shuiqiling/-stm32f103C8T6-PCB-/THIRD_PARTY.md

# 第三方代码与说明

| 路径 | 来源 |
| --- | --- |
| `firmware/Libraries/CMSIS/` | ARM CMSIS Cortex-M3 与 ST STM32F10x 器件支持；保留文件原始版权和使用说明 |
| `firmware/Libraries/STM32F10x_StdPeriph_Driver/` | STMicroelectronics 标准外设库 V3.5.0；保留原始版权和使用说明 |
| `firmware/User/stm32f10x_conf.h`、`stm32f10x_it.c`、`stm32f10x_it.h` | 原工程的 ST 配置/中断模板及其修改，以文件头为准 |

硬件设计参考公开教程完成。未为第三方文件重新指定许可证，也未为作者代码新增统一 MIT 等许可。复用前请查看对应文件原始说明；作者代码的统一许可可由作者后续明确。
