shuiqiling/-stm32f103C8T6-PCB-/hardware/pcb/pcb-layout.pdf

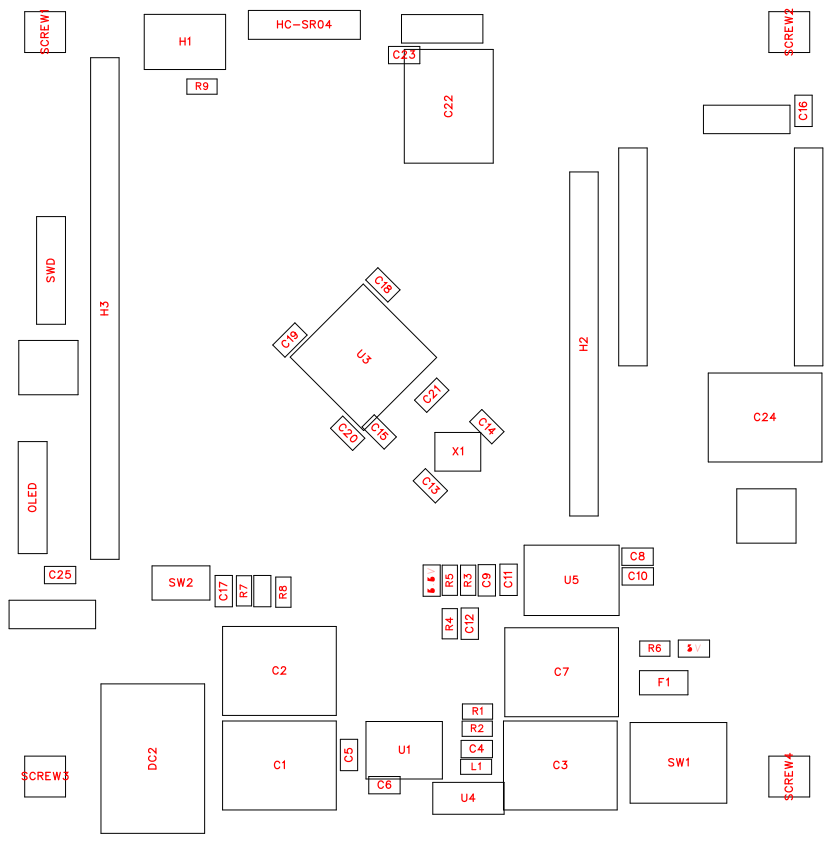
[picture p3: page 1]

No. | Quantity | Comment | Designator | Footprint | Value | Manufacturer Part | Manufacturer | Supplier Part | Supplier | Device | Name
1 | 3 | LED_0603-G | 3.3V指示灯,5V指示灯,复位 指示灯 | LED_0603 | | | | | | LED_0603-G
2 | 3 | 470UF | C1,C22,C24 | CAP-SMD_B D8.0-L8.3-W 8.3-LS9.3-FD -2 | | 470UF | | C990002296 7 | LCSC | 铝电解电容 | 470UF
3 | 1 | 10UF | C2 | CAP-SMD_B D8.0-L8.3-W 8.3-LS9.3-FD -2 | | 10UF | | C990002296 7 | LCSC | 铝电解电容 | 10UF
4 | 1 | 22UF | C3 | CAP-SMD_B D8.0-L8.3-W 8.3-LS9.3-FD -2 | | 22UF | | C990002296 7 | LCSC | 铝电解电容 | 22UF
5 | 13 | 100nF | C4,C5,C6,C8,C11,C12,C15, C17,C18,C19,C20,C21,C23 | C0603 | 100nF | | | | | CAP_0603 | 100nF
6 | 1 | 100UF | C7 | CAP-SMD_B D8.0-L8.3-W 8.3-LS9.3-FD -2 | | 100UF | | C990002296 7 | LCSC | 铝电解电容 | 100UF
7 | 2 | 10UF | C9,C10 | C0603 | 10UF | | | | | CAP_0603 | 10UF
8 | 2 | 20pF | C13,C14 | C0603 | 20pF | | | | | CAP_0603 | 20pF
9 | 2 | 1nF | C16,C25 | C0603 | 1nF | | | | | CAP_0603 | 1nF
10 | 1 | DC-005_2.0 | DC2 | DC-2.0 | | | | | | DC-005_2.0
11 | 1 | JK-nSMD005 | F1 | F1206 | | JK-nSMD005 | JK(金科) | C369153 | LCSC | JK-nSMD005 | JK-nSMD005
12 | 1 | HDR-M_2.54 _2x3 | H1 | HDR-TH_6P-P2.54-V-R2-C3-S2.54_A2 541WV-2X3P | | | | C402781 | | HDR-M_2.54 _2x3
13 | 1 | HDR-M_2.54 _1x13P | H2 | HDR-TH_13 P-P2.54-V-M | | | | C2894936 | | HDR-M_2.54 _1x13P
14 | 1 | HDR-M_2.54 _1x19P | H3 | HDR-TH_19 P-P2.54-V-M | | | | C725951 | | HDR-M_2.54 _1x19P
15 | 2 | HDR-F_2.54 _1x4P | HC-SR04,OLED | HDR-TH_4P-P2.54-V-F | | | | C2718488 | | HDR-F_2.54 _1x4P
16 | 1 | 15uH | L1 | L0603 | 15uH | | | | | L_0603 | 15uH
17 | 4 | 10K | R1,R6,R7,R9 | R0603 | 10K | | | | | Res_0603 | 10K
18 | 1 | 3.16K | R2 | R0603 | 3.16K | | | | | Res_0603 | 3.16K
19 | 2 | 0 | R3,R4 | R0603 | 0 | | | | | Res_0603 | 0
20 | 2 | 4.7K | R5,R8 | R0603 | 4.7K | | | | | Res_0603 | 4.7K
21 | 4 | M2螺丝 | SCREW1,SCREW2,SCRE W3,SCREW4 | M2螺丝 | | | | | | M2螺丝
22 | 1 | 滑动开关6P 贴片,两档 | SW1 | SW-SMD_6P -L9.0-W3.5-P 2.50-LS6.8 | | 滑动开关6P 贴片,两档 | | C990002102 5 | LCSC | 滑动开关6P 贴片,两档 | 滑动开关6P 贴片,两档
23 | 1 | Key_SMD_3 x4x2 | SW2 | Key_SMD_3 x4x2 | | | | | | Key_SMD_3 x4x2

24 | 1 | HDR-M_2.54 _1x4P | SWD | HDR-TH_4P-P2.54-V-M | | | | C492403 | | HDR-M_2.54 _1x4P
25 | 1 | TPS5450QD DARQ1 | U1 | SOIC-8_L4.9 -W3.9-P1.27-LS6.0-BL-EP | | TPS5450QD DARQ1 | TI(德州仪器 ) | C181270 | LCSC | TPS5450QD DARQ1 | TPS5450QD DARQ1
26 | 1 | STM32F103 C8T6 | U3 | LQFP-48_L7. 0-W7.0-P0.5 0-LS9.0-BL | | STM32F103 C8T6 | ST(意法半导 体) | C8734 | LCSC | STM32F103 C8T6 | STM32F103 C8T6
27 | 1 | SS54 | U4 | SMA_L4.2-W 2.6-LS5.1-R D | | SS54 | | C990002321 9 | LCSC | SS54 | SS54
28 | 1 | AMS1117-3. 3 | U5 | SOT-223-3_L 6.5-W3.4-P2. 30-LS7.0-BR | | AMS1117-3. 3 | AMS | C6186 | LCSC | AMS1117-3. 3_C6186 | AMS1117-3. 3
29 | 1 | 8MHz | X1 | CRYSTAL-S MD_4P-L3.2-W2.5-BL | 8MHz | X32258MOB 4SI | YXC(扬兴晶 振) | C2682775 | LCSC | X32258MOB 4SI | 8MHz
30 | 2 | HDR-F_2.54 _1x8P | 右排针 ,左排针 | HDR-TH_8P-P2.54-V-F-1 | | | | C27438 | | HDR-F_2.54 _1x8P
31 | 2 | HDR-F_2.54 _1x3P | 右测速 ,左测速 | HDR-TH_3P-P2.54-V-F | | | | C541850 | | HDR-F_2.54 _1x3P
32 | 2 | HDR-F_2.54 _2x2 | 右电机 ,左电机 | HDR-TH_4P-P2.54-V-F-R 2-C2-S2.54 | | | | C92273 | | HDR-F_2.54 _2x2
33 | 1 | HDR-M_2.54 _1x3P | 舵机 | HDR-TH_3P-P2.54-V-M | | | | C2937625 | | HDR-M_2.54 _1x3P

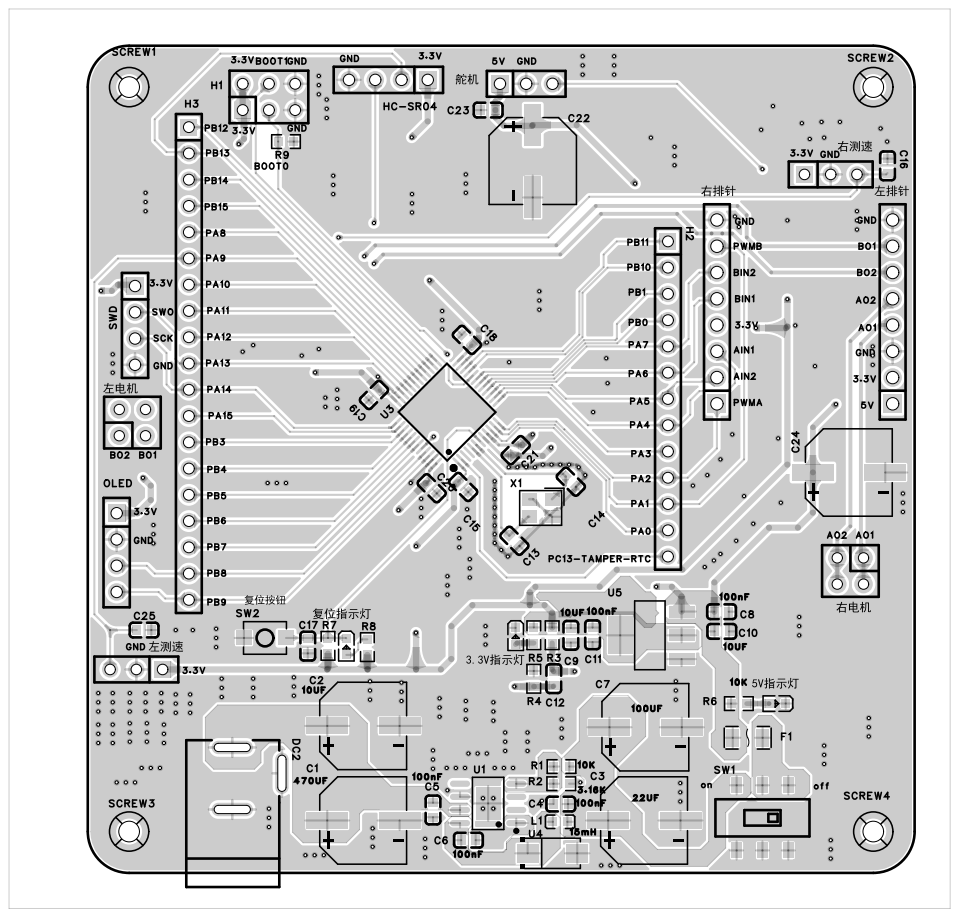
[picture p4: page 5]

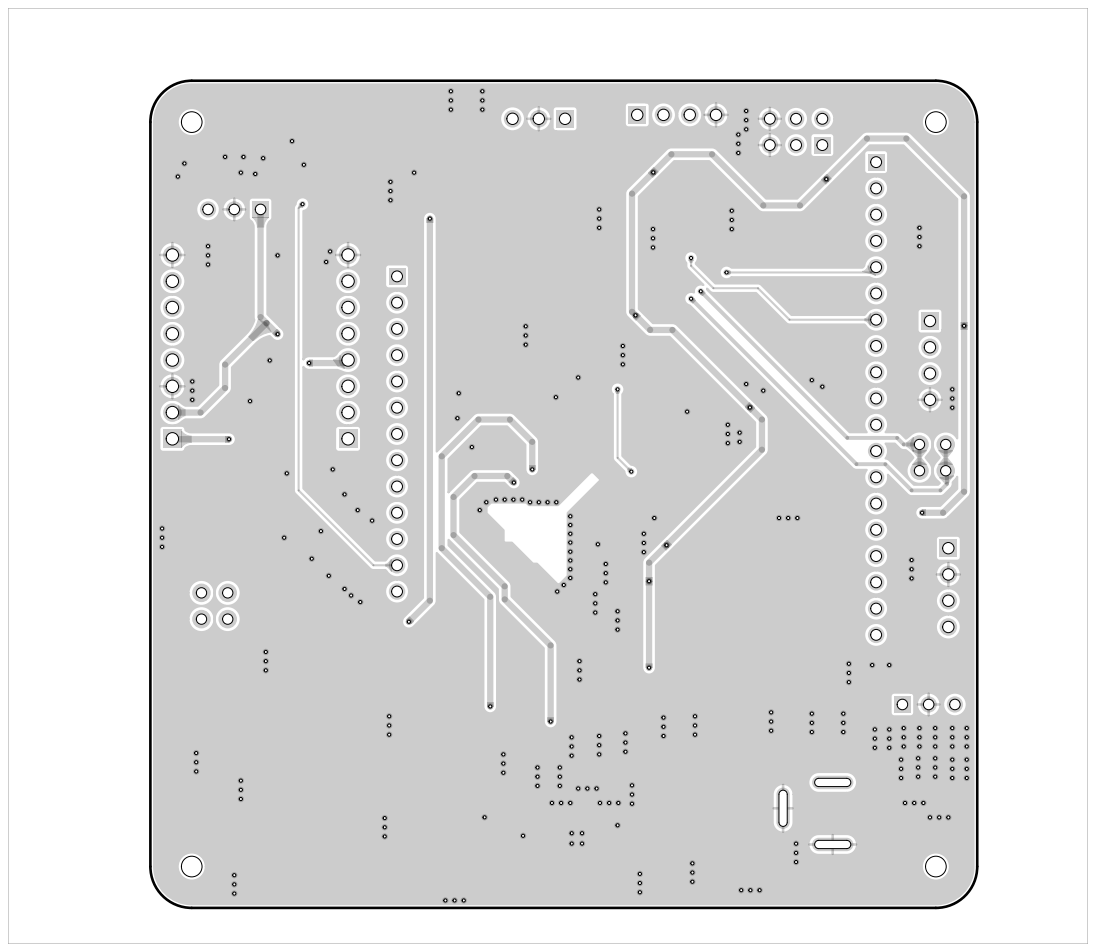
[picture p5: page 6]

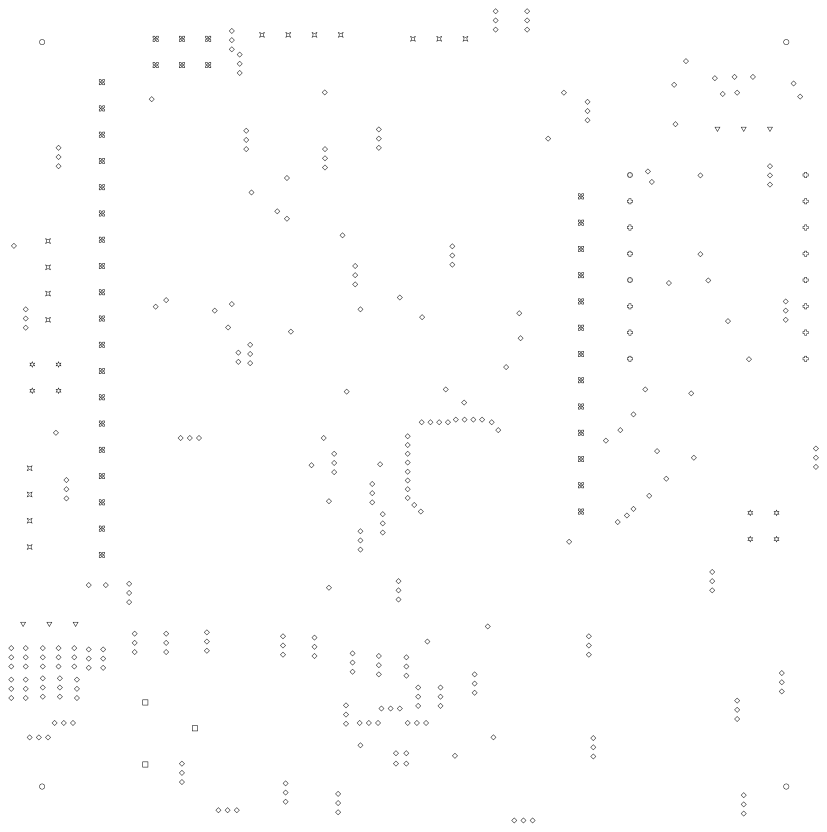
[picture p6: page 7]
