shuiqiling/-stm32f103C8T6-PCB-/hardware/schematic/schematic.pdf

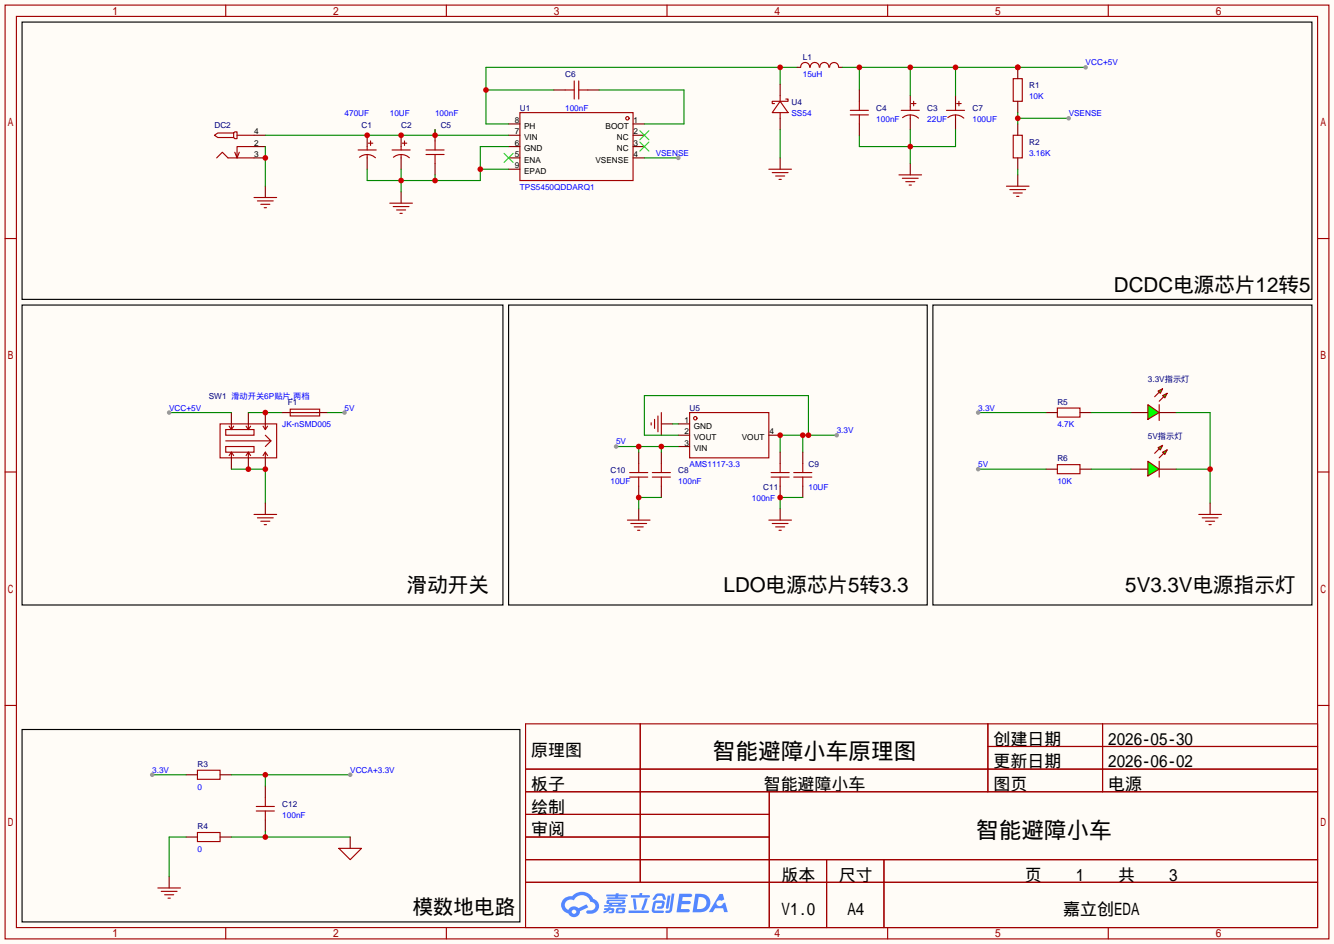
[picture p7: page 1]

原理图 | 智能避障小车原理图 | 创建日期 | 2026-05-30

更新日期 | 2026-06-02

板子 | 智能避障小车 | 图页 | 电源
绘制 | | 智能避障小车
审阅

V1.0 | A4 | 嘉立创EDA

晶振电路 | BOOT配置

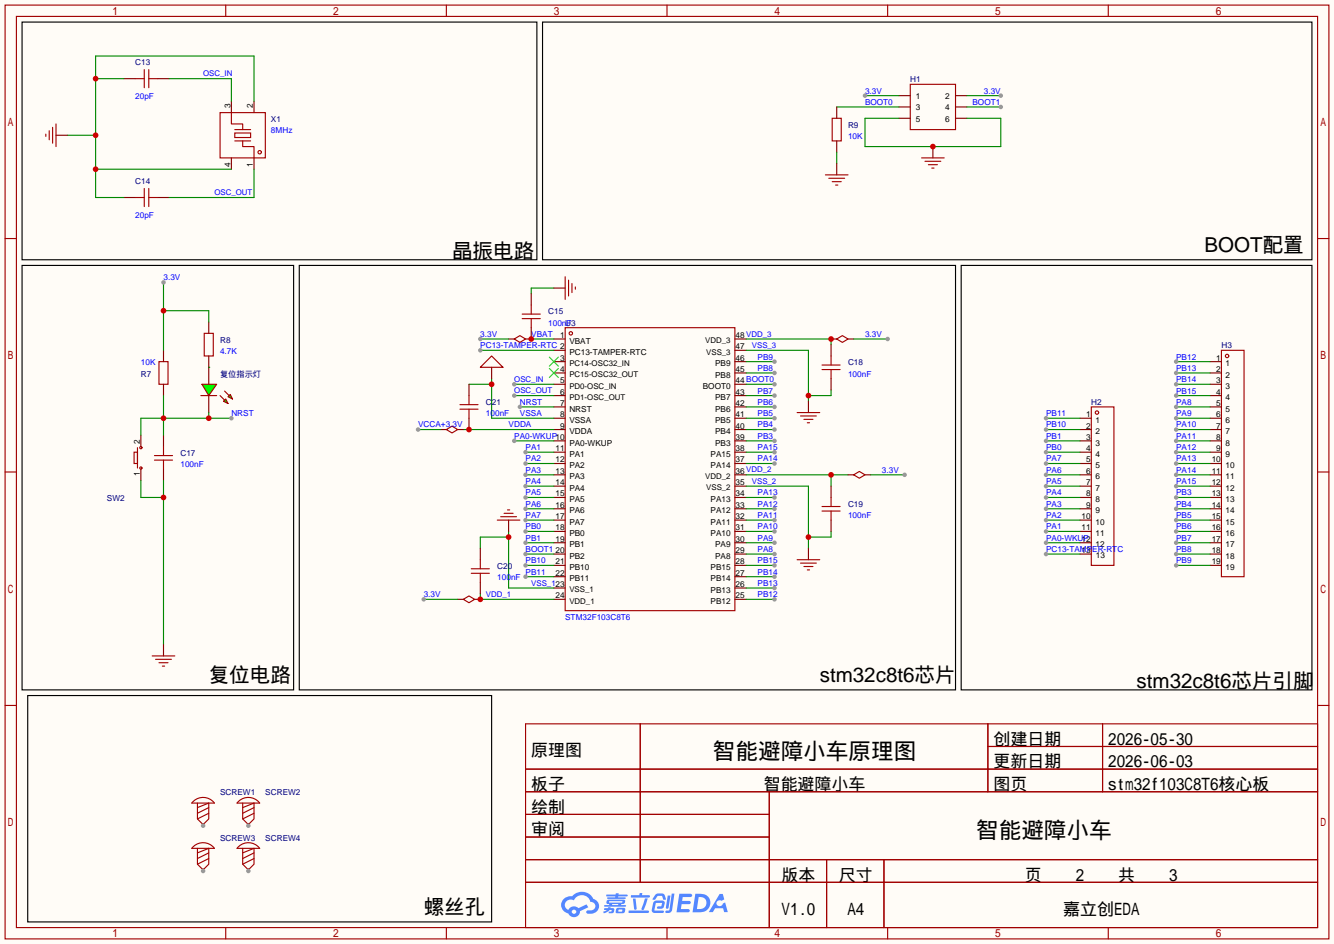
[picture p8: page 2]

原理图 | 智能避障小车原理图 | 创建日期 | 2026-05-30

更新日期 | 2026-06-03

板子 | 智能避障小车 | 图页 | stm32f103C8T6核心板
绘制 | | 智能避障小车
审阅

# Motor： in1：A4(A),A6(B)；

in2：A5(A),A7(B);

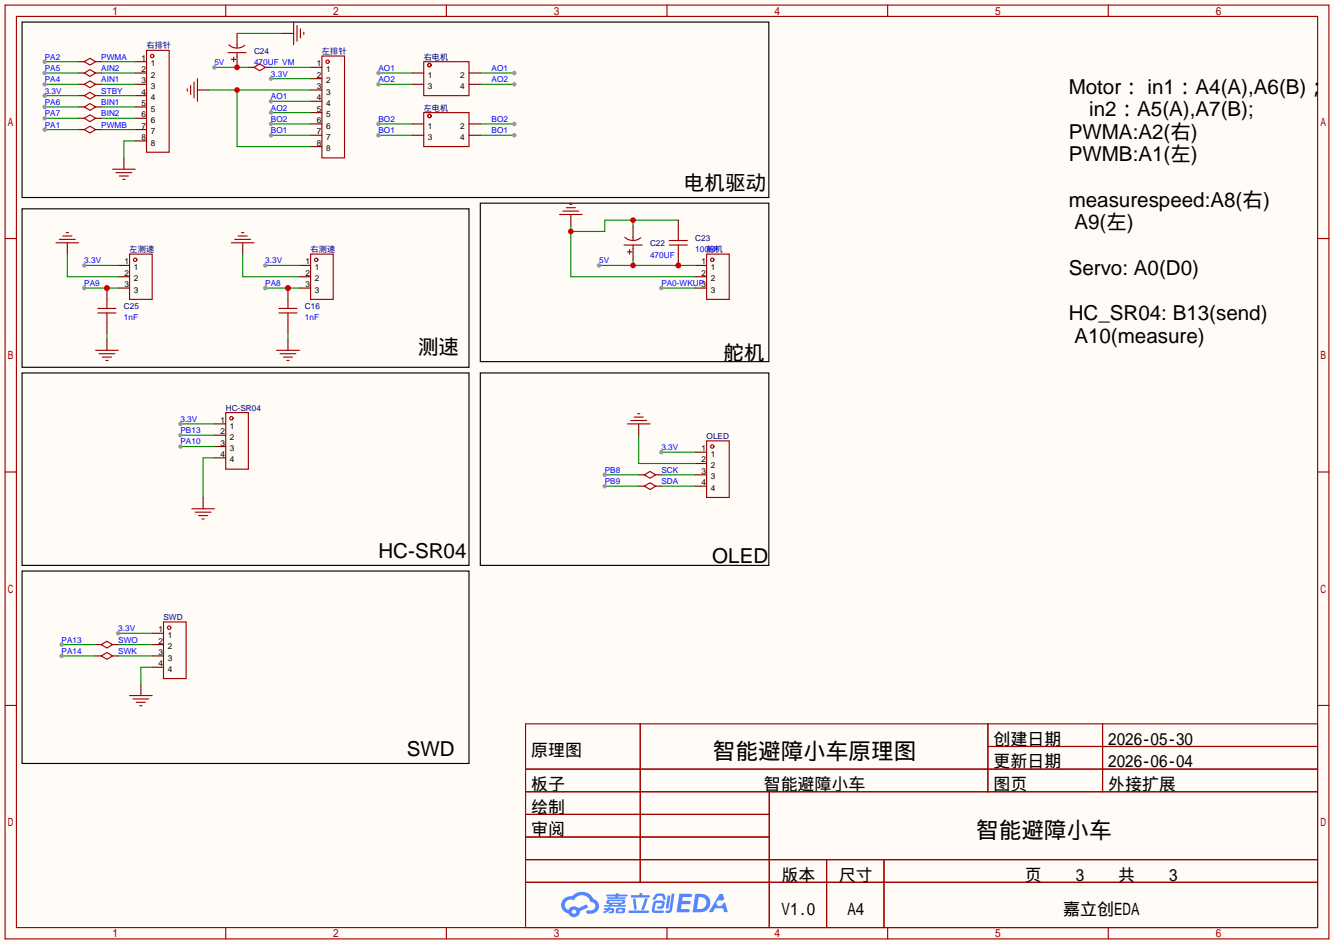
[picture p9: page 3]

原理图 | 智能避障小车原理图 | 创建日期 | 2026-05-30

更新日期 | 2026-06-04

板子 | 智能避障小车 | 图页 | 外接扩展
绘制 | | 智能避障小车
审阅
