shuiqiling/-stm32f103C8T6-PCB-/firmware/Hardware/Encoder.c

#include "stm32f10x.h"    // Device header
int16_t Temp;
int16_t Now;
void Encoder_Init(void)
{
	RCC_APB2PeriphClockCmd(RCC_APB2Periph_GPIOA,ENABLE);
	RCC_APB1PeriphClockCmd(RCC_APB1Periph_TIM3,ENABLE);

	GPIO_InitTypeDef GPIO_InitStruct;
	GPIO_InitStruct.GPIO_Mode=GPIO_Mode_IPU;
	GPIO_InitStruct.GPIO_Pin=GPIO_Pin_6|GPIO_Pin_7;
	GPIO_InitStruct.GPIO_Speed=GPIO_Speed_50MHz;
	GPIO_Init(GPIOA,&GPIO_InitStruct);


	TIM_TimeBaseInitTypeDef TIM_TimeBaseInitStruct;
	TIM_TimeBaseInitStruct.TIM_ClockDivision=TIM_CKD_DIV1;
	TIM_TimeBaseInitStruct.TIM_CounterMode=TIM_CounterMode_Up;
	TIM_TimeBaseInitStruct.TIM_Period=65536-1;
	TIM_TimeBaseInitStruct.TIM_Prescaler=1-1;
	TIM_TimeBaseInitStruct.TIM_RepetitionCounter=0x00;
	TIM_TimeBaseInit(TIM3,&TIM_TimeBaseInitStruct);

    TIM_ICInitTypeDef TIM_ICInitStruct;

	TIM_ICStructInit(&TIM_ICInitStruct);

	TIM_ICInitStruct.TIM_Channel=TIM_Channel_1;
	TIM_ICInitStruct.TIM_ICSelection=TIM_ICSelection_DirectTI;
	TIM_ICInitStruct.TIM_ICFilter=0xF;
	TIM_ICInit(TIM3,&TIM_ICInitStruct);

	TIM_ICStructInit(&TIM_ICInitStruct);
	TIM_ICInitStruct.TIM_Channel=TIM_Channel_2;
	TIM_ICInitStruct.TIM_ICSelection=TIM_ICSelection_DirectTI;
	TIM_ICInitStruct.TIM_ICFilter=0xF;
	TIM_ICInit(TIM3,&TIM_ICInitStruct);
	TIM_EncoderInterfaceConfig(TIM3,TIM_EncoderMode_TI12,TIM_ICPolarity_Rising,TIM_ICPolarity_Rising);

	TIM_SetCounter(TIM3,0);
	TIM_Cmd(TIM3,ENABLE);
}

int16_t Encoder_Getcount(void)
{
	return TIM_GetCounter(TIM3)+1;
}


int16_t Encoder_GetSpeed(void)
{
	Now=TIM_GetCounter(TIM3)-Temp;
    Temp=TIM_GetCounter(TIM3);
	return Now;


}
