shuiqiling/-stm32f103C8T6-PCB-/firmware/HAL/HAL.h

#ifndef __HAL_H
#define __HAL_H

#include <stdlib.h>

#include "Delay.h"                  // Device header
#include "OLED.h"
#include "Servo.h"
#include "TIM.h"
#include "PWM.h"
#include "Motor.h"
#include "MPU6050.h"
#include "MeasureSpeed.h"
#include "HC_SR04.h"



#include "HAL_MeasureSpeed.h"
#include "HAL_Servo.h"
#include "HAL_PWM.h"
#include "HAL_Motor.h"
#include "HAL_MPU6050.h"
#include "HAL_HC_SR04.h"

#include "MotorPID.h"
#include "Filtering.h"
#include "Sorting.h"



#include "APP_ActionControl.h"
#include "APP_Obstacle_Avoidance.h"



#endif
