shuiqiling/-stm32f103C8T6-PCB-/firmware/HAL/HAL_MPU6050.h

#ifndef __HAL_MPU6050_H
#define __HAL_MPU6050_H

void HAL_MPU6050_Init(void);

void HAL_MPU6050_SendByte(uint8_t MPU6050_Address,uint8_t SendByte);
uint8_t HAL_MPU6050_ReadByte(uint8_t MPU6050_Address);

void HAL_MPU6050_GetAGValue(int16_t *Ax,int16_t *Ay,int16_t *Az,int16_t *Gx,int16_t *Gy,int16_t *Gz);



#endif
