shuiqiling/-stm32f103C8T6-PCB-/firmware/Hardware/BUZ.c

#include "stm32f10x.h"                  // Device header


void BUZ_Init(void)
{
	RCC_APB2PeriphClockCmd(RCC_APB2Periph_GPIOB,ENABLE);
	GPIO_InitTypeDef GPIO_InitB;
	GPIO_InitB.GPIO_Mode=GPIO_Mode_Out_PP;
	GPIO_InitB.GPIO_Pin=GPIO_Pin_12;
	GPIO_InitB.GPIO_Speed=GPIO_Speed_50MHz;
	GPIO_Init(GPIOB,&GPIO_InitB);
}
