shuiqiling/-stm32f103C8T6-PCB-/firmware/Hardware/PWM.c

#include "stm32f10x.h"                  // Device header

void PWM_Init(void)
{
	RCC_APB1PeriphClockCmd(RCC_APB1Periph_TIM2,ENABLE);

	TIM_InternalClockConfig(TIM2);
	TIM_TimeBaseInitTypeDef TIM_TimeBaseInitStruct;
	TIM_TimeBaseInitStruct.TIM_ClockDivision=TIM_CKD_DIV1;
	TIM_TimeBaseInitStruct.TIM_CounterMode=TIM_CounterMode_Up;
	TIM_TimeBaseInitStruct.TIM_Period=20000-1;
	TIM_TimeBaseInitStruct.TIM_Prescaler=72-1;
	TIM_TimeBaseInitStruct.TIM_RepetitionCounter=0x00;
	TIM_TimeBaseInit(TIM2, &TIM_TimeBaseInitStruct);

	TIM_OCInitTypeDef TIM_OCInitStruct;
	TIM_OCStructInit(&TIM_OCInitStruct);

	TIM_OCInitStruct.TIM_OCMode=TIM_OCMode_PWM1;
	TIM_OCInitStruct.TIM_OCPolarity=TIM_OCPolarity_High;
	TIM_OCInitStruct.TIM_OutputState=TIM_OutputState_Enable;
	TIM_OCInitStruct.TIM_Pulse=0;
	TIM_OC1Init(TIM2,&TIM_OCInitStruct);

	TIM_OCInitStruct.TIM_OCMode=TIM_OCMode_PWM1;
	TIM_OCInitStruct.TIM_OCPolarity=TIM_OCPolarity_High;
	TIM_OCInitStruct.TIM_OutputState=TIM_OutputState_Enable;
	TIM_OCInitStruct.TIM_Pulse=0;
	TIM_OC2Init(TIM2,&TIM_OCInitStruct);

	TIM_OCInitStruct.TIM_OCMode=TIM_OCMode_PWM1;
	TIM_OCInitStruct.TIM_OCPolarity=TIM_OCPolarity_High;
	TIM_OCInitStruct.TIM_OutputState=TIM_OutputState_Enable;
	TIM_OCInitStruct.TIM_Pulse=0;
	TIM_OC3Init(TIM2,&TIM_OCInitStruct);


    TIM_Cmd(TIM2,ENABLE);
}

void PWM_ChangeCCR1(uint16_t Compare)
{
	TIM_SetCompare1(TIM2,Compare);
}

void PWM_ChangeCCR2(uint16_t Compare)
{
	TIM_SetCompare2(TIM2,Compare);
}


void PWM_ChangeCCR3(uint16_t Compare)
{
	TIM_SetCompare3(TIM2,Compare);
}
