shuiqiling/-stm32f103C8T6-PCB-/(commit log)

2026-06-04 程序与立创eda
2026-10-19 refactor: organize STM32 firmware and hardware project
    Expand firmware into browsable modules, preserve original archive and hardware exports, fix portable Keil paths, and add project documentation and structural verification.
